simat/Variable-J1772-Charger/J1772.pdf

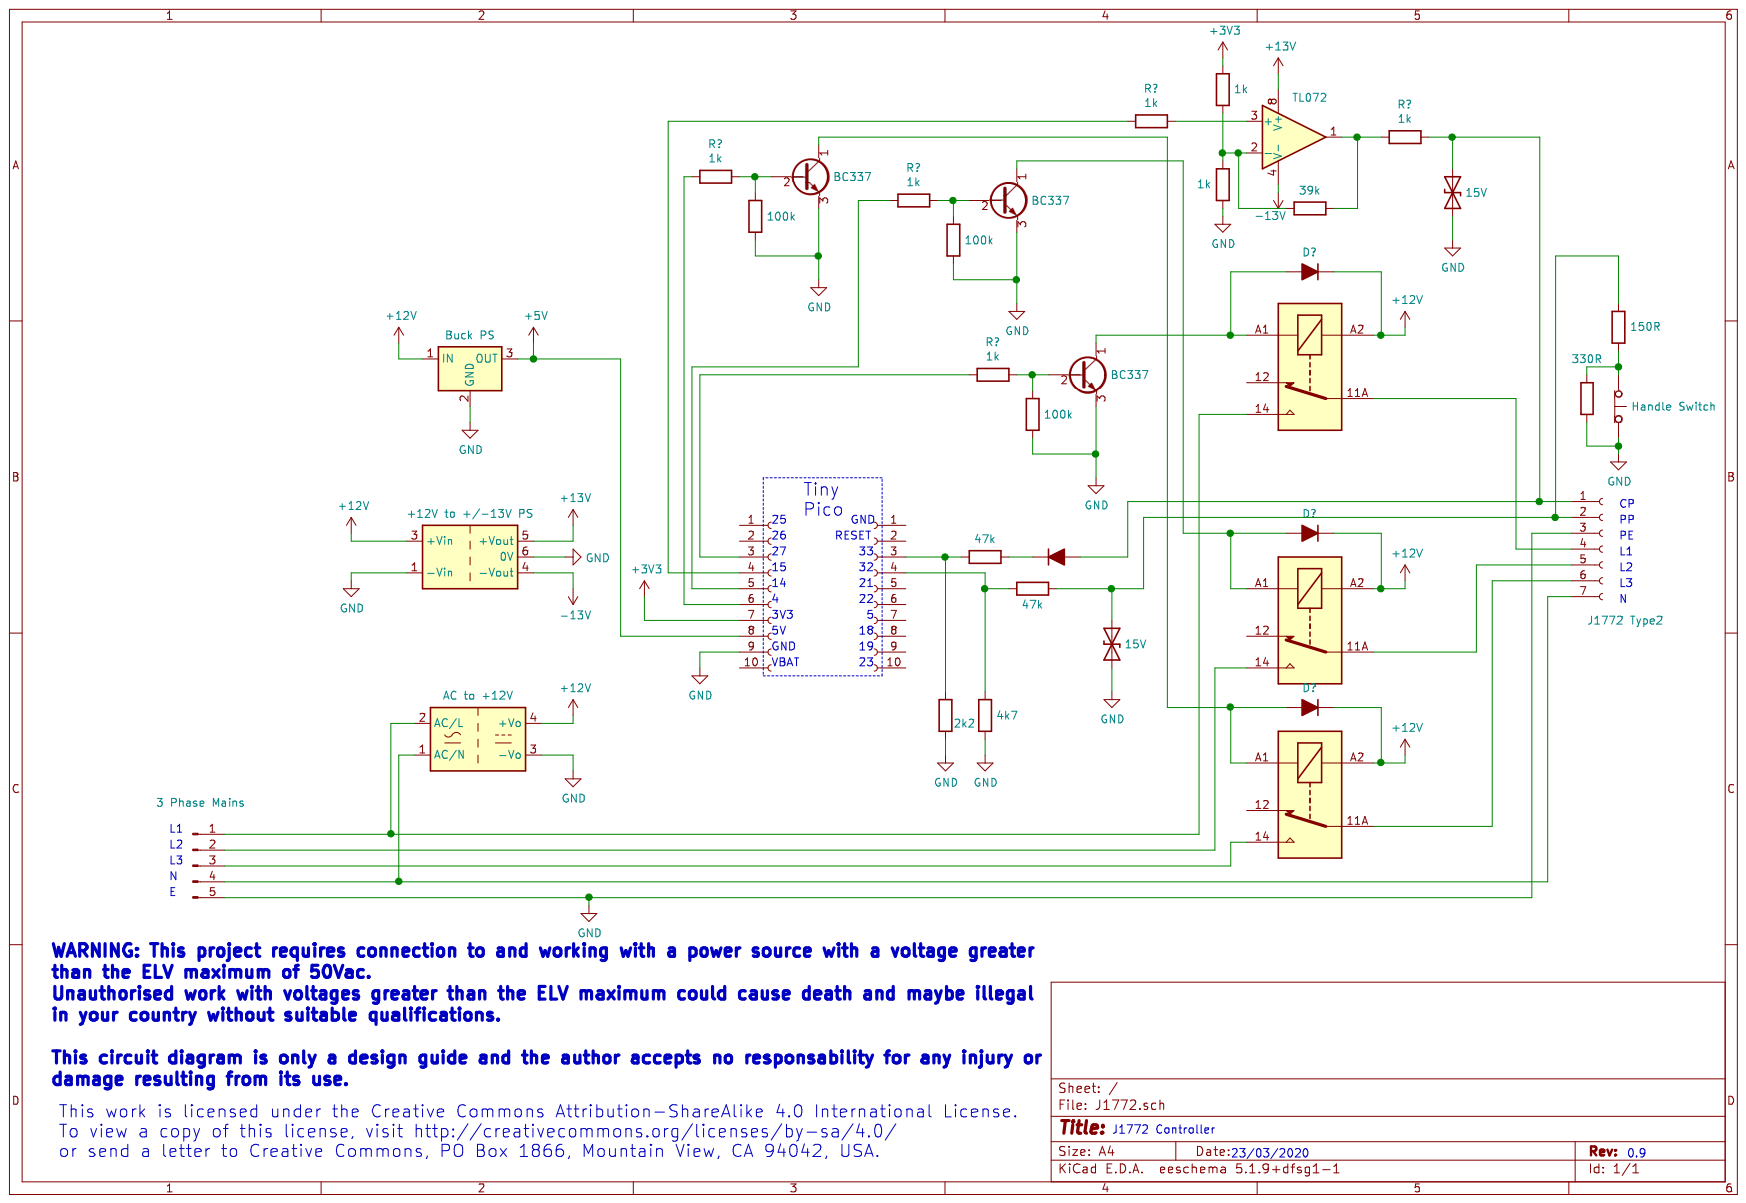
[picture p1: page 1]
