simat/Variable-J1772-Charger/(commit log)

2020-03-24 add code to handle CP error voltage
    [evcharge.py]
2020-03-24 Add code to put errors in error log
    [evcharge.py]
2020-03-24 fix bug in error code
    [evcharge.py]
2020-09-19 Add logging, fix bugs
    [evcharge.py, logger.py, net.py]
2020-11-21 Add minimum power and changes to when to start and stop charging based on minimum power
2021-01-31 Impliment max and min power available
2021-06-21 Changed schematics
    Change circuit to have individual control of each phase relay
    [J1772.sch]
2021-10-09 commit many changes, new stand aloone mode, connect to one of several networks, bugfixes and improvements
    modified: config.py
    modified: evcharge.py
    modified: main.py
    modified: net.py
    [config.py, evcharge.py, main.py, net.py]
