simat/Variable-J1772-Charger/(notices)

Notices in the files:
net.py:
Copyright (C) 2020 Simon Richard Matthews
This program is free software; you can redistribute it and/or modify
it under the terms of the GNU General Public License as published by
the Free Software Foundation; either version 2 of the License, or
any later version.
